micbay/RaceTimerAndController/Images/Adafruit_Bargraph-24_Winner_Lane1_600x125.png

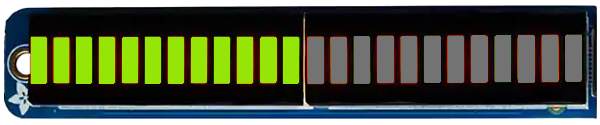
Images/Adafruit_Bargraph-24_Winner_Lane1_600x125.png
