micbay/RaceTimerAndController/Images/ArduinoNanopPinOut_RealHardware.png

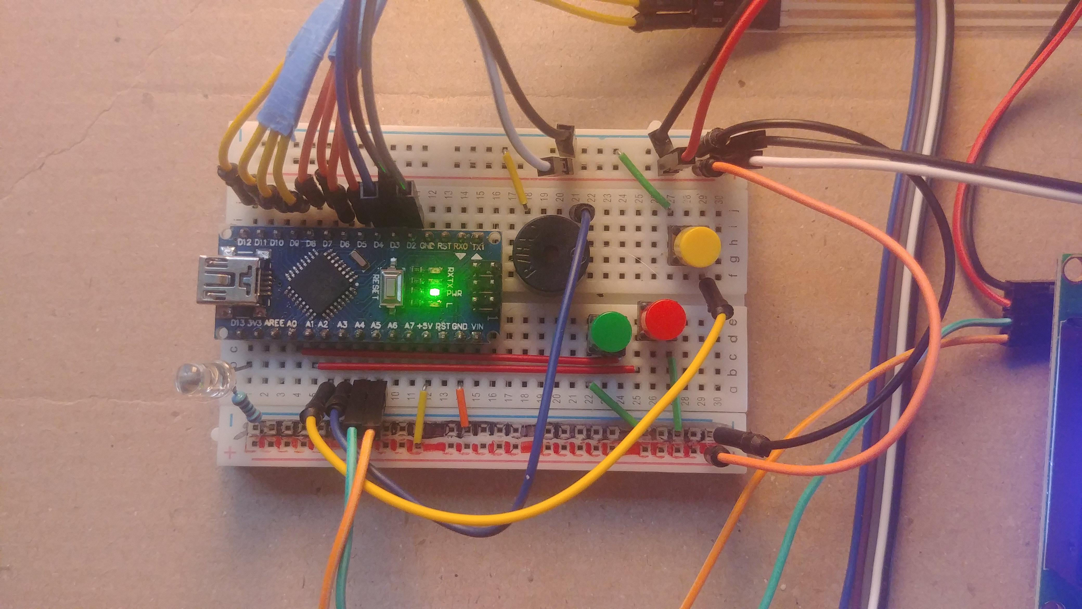
Images/ArduinoNanopPinOut_RealHardware.png
