micbay/RaceTimerAndController/Images/ChangeSettingsWithAudio.png

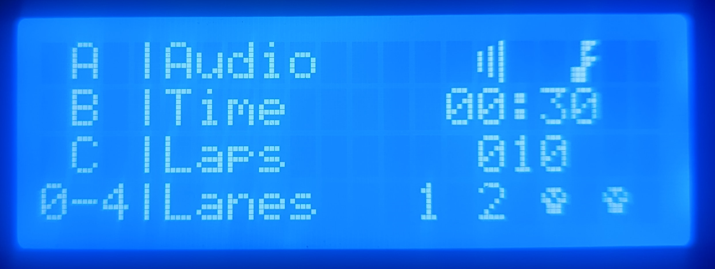
Images/ChangeSettingsWithAudio.png
