micbay/RaceTimerAndController/Images/Displays_DemoStartup.png

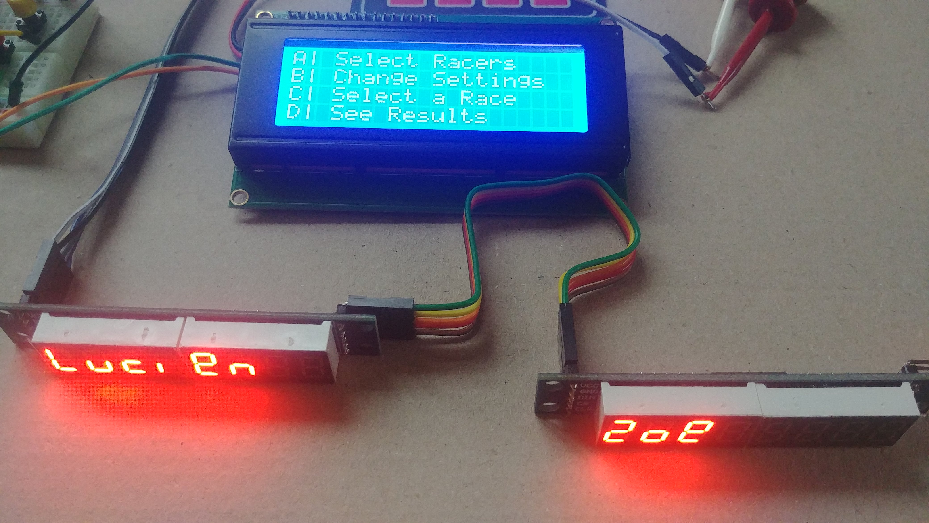
Images/Displays_DemoStartup.png
