micbay/RaceTimerAndController/Images/Hall-Effect-Sensor-Module-KY-003.png

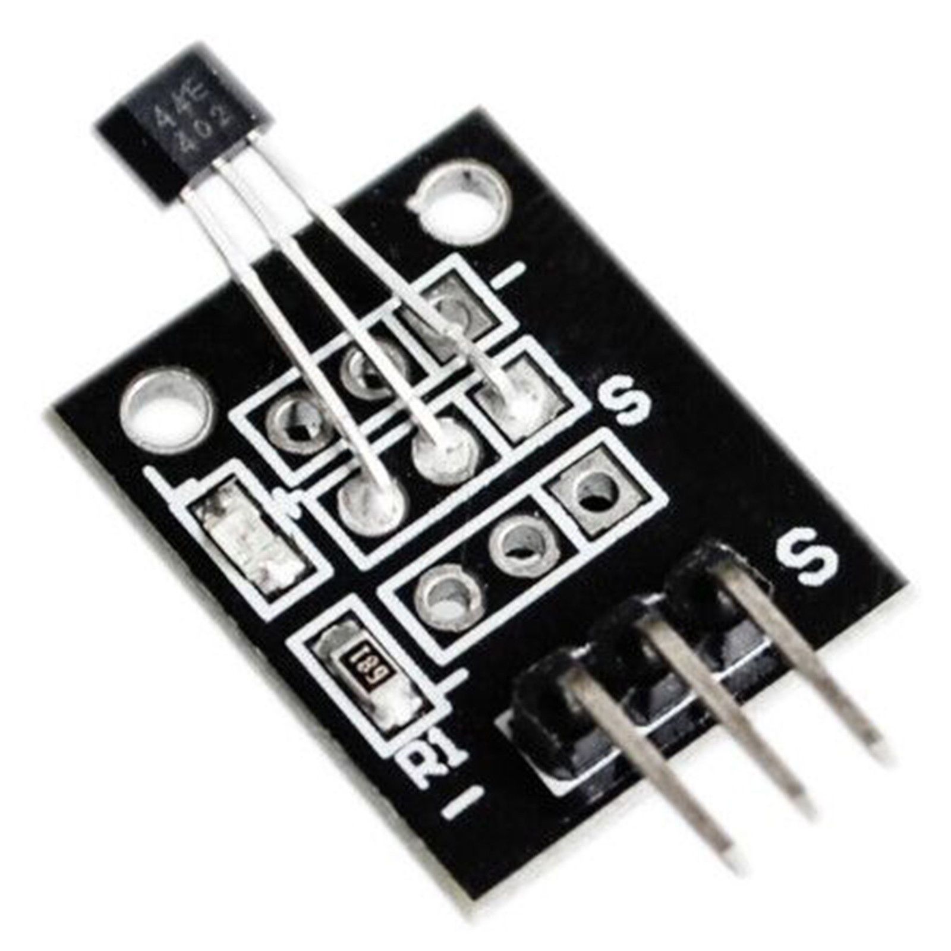
Images/Hall-Effect-Sensor-Module-KY-003.png
