micbay/RaceTimerAndController/Images/LED_PauseScreens.png

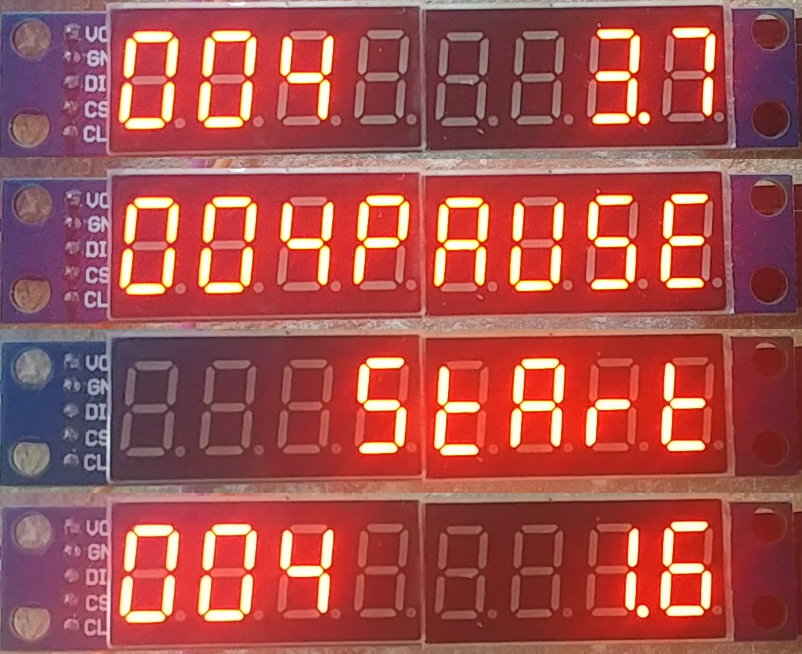
Images/LED_PauseScreens.png
