micbay/RaceTimerAndController/Images/MainMenu.png

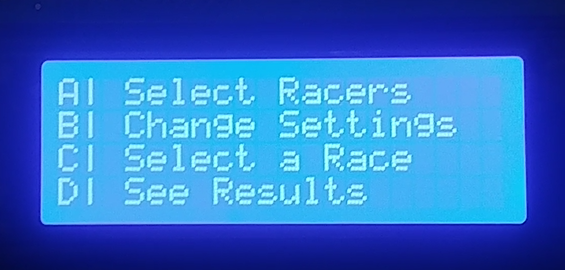
Images/MainMenu.png
