micbay/RaceTimerAndController/Images/Paperclip_Switch_withCar_Strip.png

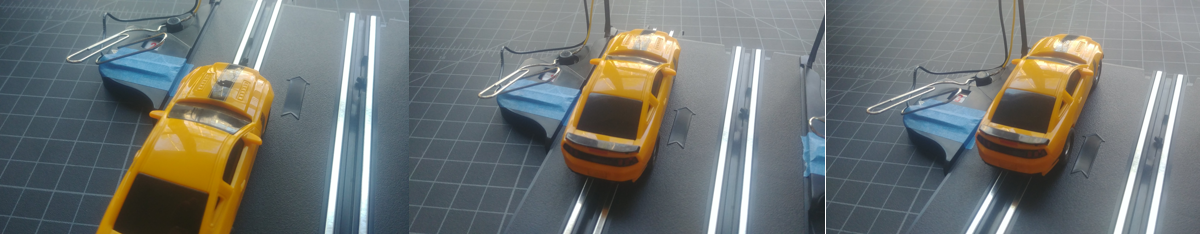
Images/Paperclip_Switch_withCar_Strip.png
