micbay/RaceTimerAndController/Images/pcswitch_withcar1.jpg

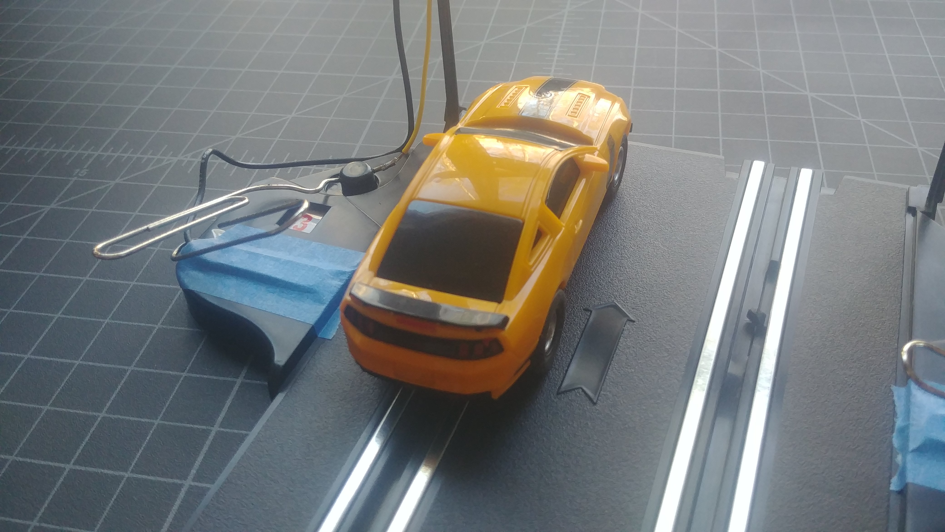
Images/pcswitch_withcar1.jpg
