micbay/RaceTimerAndController/Images/Racer_Display_ssxx.png

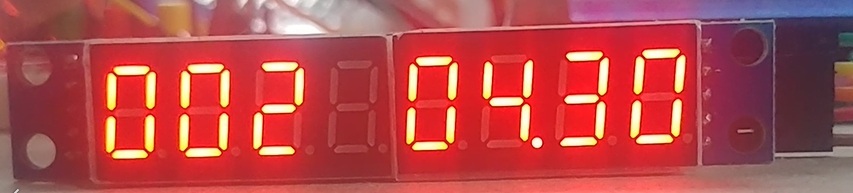
Images/Racer_Display_ssxx.png
