micbay/RaceTimerAndController/Images/Racer_Display_ssxxx.png

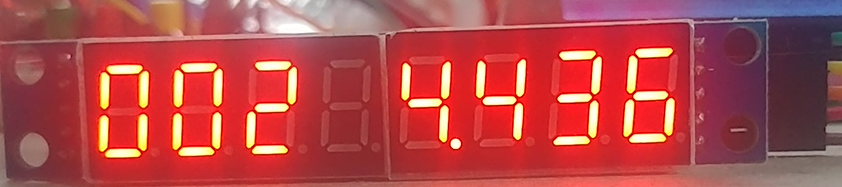
Images/Racer_Display_ssxxx.png
