micbay/RaceTimerAndController/Images/ScreenShots/StartRace_Menu.png

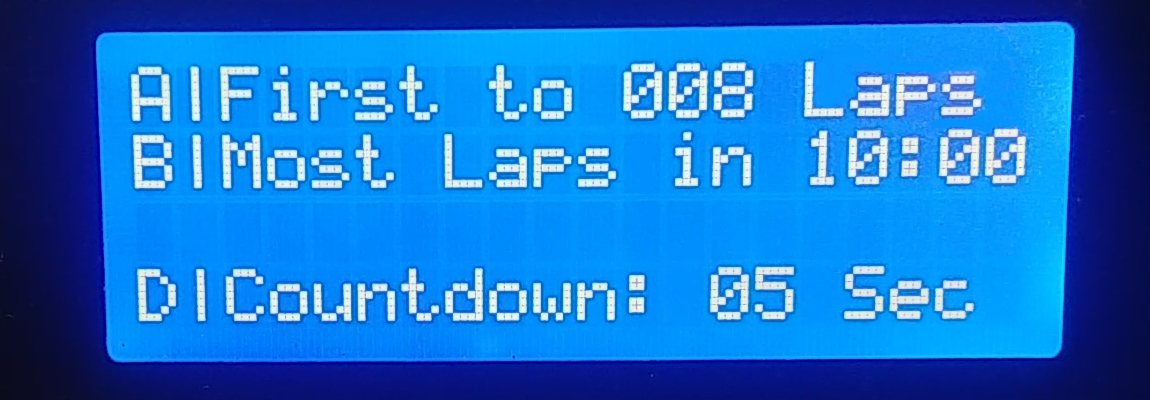
Images/ScreenShots/StartRace_Menu.png
