micbay/RaceTimerAndController/Images/10uF_CapSoldered.png

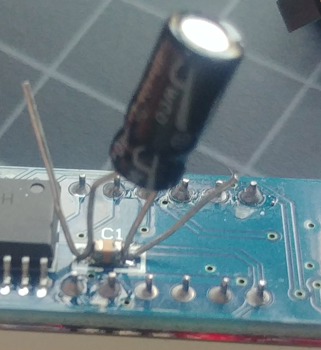
Images/10uF_CapSoldered.png
