micbay/RaceTimerAndController/Images/GroundLoopEx_Bad_Wiring.png

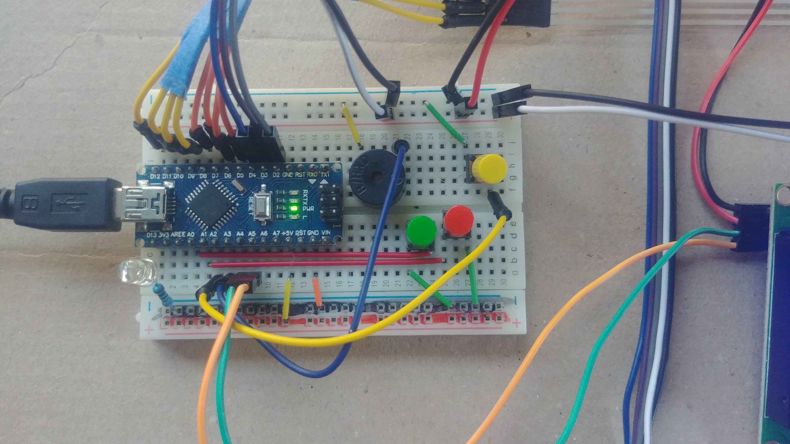
Images/GroundLoopEx_Bad_Wiring.png
