micbay/RaceTimerAndController/Images/WiringDiagram1600x800.png

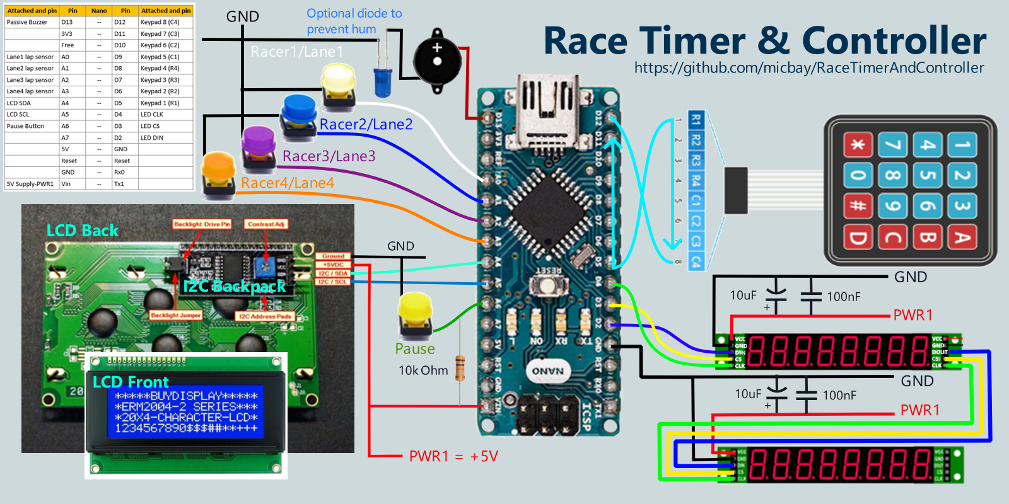
Images/WiringDiagram1600x800.png
