micbay/RaceTimerAndController/Images/ScreenShots/Racer1Results_ScrolledDown_Menu.png

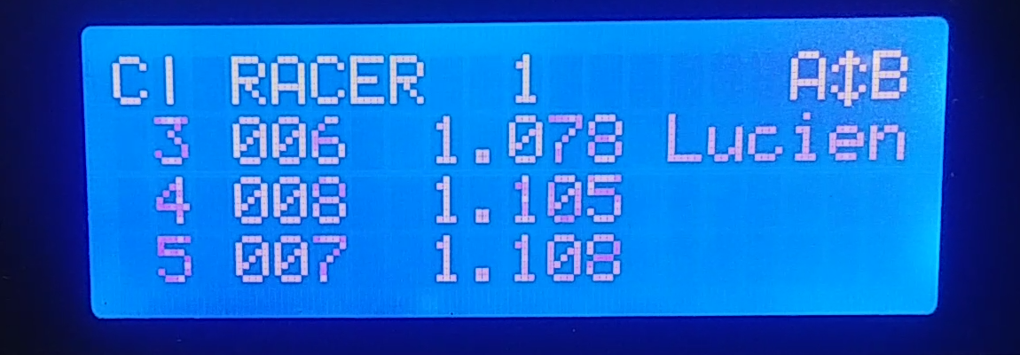
Images/ScreenShots/Racer1Results_ScrolledDown_Menu.png
