micbay/RaceTimerAndController/(threads)

Thread 1 (2023-01-02):

Wrong racer name in live race results view

zhvial, 2023-01-02:
Even through  you change racer name in menu - live race display shows racer names 1 and 2 from Racers[] array. 7 segment display shows correct names, end results are also corrrect, but live race display and "finish" display is not correct. Also winning melody is playing for first or second racer from array, whatever racer you have selected  before from menu.

Here is the video where I'm showing the bug
[https://youtu.be/86N7HagvqQE](https://www.youtube.com/watch?v=86N7HagvqQE)

zhvial, 2023-01-03:
I've found how to solve the problem.
I do not know how to make pull request so posting here:

line 2085:
startPlayRtttlPGM(buzzPin1, victorySong[laneRacer[i]]);

line 2113
startPlayRtttlPGM(buzzPin1, victorySong[laneRacer[leaderBoard[0][1]]]);

line 1453

PrintText(Racers[laneRacer[leaderBoard[k-1][1]]], lcdDisp, 11, 6, false, k);

line 1458

PrintText(Racers[laneRacer[overallFastestRacer]], lcdDisp, 19, 6, false, 3);

micbay, 2023-01-05:
I have added the above changes and the current master branch should now contain the fix. Thanks for finding it and posting it.

Closed 2023-01-05.

Thread 2 (2023-01-02):

Pin definition does not change pin assignation to racing lines.

zhvial, 2023-01-02:
In the code there is pin definition. It is confusing, because if you change the order of lines (lets say you wand A3 for lane1) it doesnt affect the program.

const byte lane1Pin = PIN_A0;
const byte lane2Pin = PIN_A1;
const byte lane3Pin = PIN_A2;
const byte lane4Pin = PIN_A3;

All the "magic" is done in ISR routine where bits are checked.

// Lane 1 positive trigger PINC = 0xXXXXXXX0
  // Lane 1 is on pin A0 which uses the 1st bit of the register; idx 0, of PINC Byte
  // Lane 2 positive trigger PINC = 0xXXXXXX0X
  // Lane 2 is on pin A1 which uses the 2nd bit of the register; idx 1, of PINC Byte
  // Lane 3 positive trigger PINC = 0xXXXXX0XX
  // Lane 3 is on pin A2 which uses the 3rd bit of the register; idx 2, of PINC Byte
  // Lane 4 positive trigger PINC = 0xXXXX0XXX
  // Lane 4 is on pin A3 which uses the 4th bit of the register; idx 3, of PINC Byte

I think that at least comment should be added that pins are not interchangeable

micbay, 2023-01-05:
Yeah, this was originally the plan to make it settable, but wound up using a bit shifting approach to maximize the speed through the ISR() and that broke being able to use the lane#Pin variables for the interrupts which had the side effect of locking in the interrupt byte index value to the lane#.

I've refactored it now so that there is a lanes[][] array that sets the pin and interrupt byte pair for each lane #. So now if you want to wire the pins to different lanes you can do that by just changing the row its associated pin-byte pair is in. The row of lanes[] is equal to the lane. Row zero is reserved, row 1 is lane 1, etc.

The new lanes[] variable is described in code starting around line #52

I added an example commented in the new code at line 80, showing how one might now set pin A3 to be used by lane 1,

Let me know if this didn't cover the functionality you were looking for above.

Thread 7 (2023-01-02):

Count down timer

zhvial, 2023-01-02:
After less than minute is left on count down race timer, minute chars are not deleted and 01: minute is shown.
Video link below:
https://youtu.be/AJK_NrQgwsg

micbay, 2023-01-05:
This problem was due to some errors in the PrintClock() function and PrintSpanOfChars() functions related to calculating the print width.
As the total space needed to print the current time was reduced by a clock countdown from needing minutes to just needing seconds, the part of the clock no longer used was not being cleared.
I have updated the PrintClock() to properly calculate actual clock space used and thus, also the space that needs to be cleared when no longer used.
At the same time I changed the PrintSpanOfChars() to use 'int' variables instead of 'byte' variables so that negative positions can be considered. I don't think that was part of the problem here, but was done because negative position is a possibility.
Should be fixed now in the current master.

Closed 2023-01-05.

Thread 12 (2023-03-10):

Loop in race laptimer and name

sommo, 2023-03-10:
Hi @micbay, I get it working (the startlightI2C) version.
But when choosing racer the display name is incomplete:
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
Also the chained one

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

Once the race is started, it seems getting in loop:
https://user-images.githubusercontent.com/22022996/224379609-51754355-ae42-4162-b391-85388f1c4b57.MOV

I didn't soldered any capacitor behind the two chained display, and didn't connect the Adafruit ledbar (didn't arrive yet).
Any ideas?
Thank you

sommo, 2023-03-10:
for the loop while racing, seems about the pause button, i checked again the connection (it has already the 10k resistor but i grounded better) and now it's ok, while racing no more pause/restart.
Remains the wired about display name, because on count down, all the 8digit turn on (3..2..1..) all of them, so it seems about name and pause/restart string.

I also get an "issue" the one who wins get the losing song (no idea why) and the loser one get the victory song.

micbay, 2023-03-10:
Regarding the 'Z' not showing up on LED.
You need to update the character array used by the library `LedControl.h`. The native library doesn't include every writable character so I edited it. It may not be clear from the readme, but the table shown there is a version I customized and then copied into my version of the library `LedControl`.

To get some extra letters copy the customized table from the readme (shown below) into the `LedConrol.h` file of your downloaded `LedControl` library, which, by default on windows, is found in folder:
`C:\Users\username\Documents\Arduino\libraries\LedControl\src`.

Open `LedControl.h` and swap the variable `const static byte charTable [ ]` with the one below.
```
const static byte charTable [] PROGMEM  = {
  //00  0         1         2          3        4         5         6         7
    B01111110,B00110000,B01101101,B01111001,B00110011,B01011011,B01011111,B01110000,
  //08  8         9         0         b          c        d         E         F
    B01111111,B01111011,B01110111,B00011111,B00001101,B00111101,B01001111,B01000111,
    B00000000,B00000000,B00000000,B00000000,B00000000,B00000000,B00000000,B00000000,
    B00000000,B00000000,B00000000,B00000000,B00000000,B00000000,B00000000,B00000000,
  //32                                                                        '
    B00000000,B00000000,B00000000,B00000000,B00000000,B00000000,B00000000,B00000010,
    B00000000,B00000000,B00000000,B00000000,B10000000,B00000001,B10000000,B00000000,
  //48  0         1         2          3        4         5         6         7
    B01111110,B00110000,B01101101,B01111001,B00110011,B01011011,B01011111,B01110000,
  //56  8         9
    B01111111,B01111011,B00000000,B00000000,B00000000,B00000000,B00000000,B00000000,
  //64            A         B         C       D->d        E         F         G
    B00000000,B01110111,B01111111,B01001110,B00111101,B01001111,B01000111,B01011110,
  //72  H         I         J         K         L         M         N         O
    B00110111,B00000110,B01111100,B00000000,B00001110,B00000000,B00010101,B01111110,
  //80  P       Q->q      R->r        S       T->t        U         V         W
    B01100111,B01110011,B00000101,B01011011,B00001111,B00111110,B00000000,B00000000,
  //88  X         Y         Z         K                                       _
    B00000000,B00111011,B01101101,B00000000,B00000000,B00000000,B00000000,B00001000,
  //96          a->A        b         c         d         e       f->F        g
    B00000000,B01110111,B00011111,B00001101,B00111101,B01101111,B01000111,B01111011,
  //104 h         i       j->J        k         l         m         n         o
    B00010111,B00000100,B00111100,B00000000,B00000110,B00000000,B00010101,B00011101,
  //112 p         q         r       s->S        t         u         v        w
    B01100111,B01110011,B00000101,B01011011,B00001111,B00011100,B00000000,B00000000,
  //120 x         y       z->Z
    B00000000,B00111011,B01101101,B00000000,B00000000,B00000000,B00000000,B00000000
};
```

micbay, 2023-03-10:
I don't fully understand what you are describing about the Pause, however, there is a bug I fixed while editing to add a Drag racing option related to the Pause button that is likely the issue.

Try going to line 1332, I believe, inside of the `ToggleRacePause()` function and swapping:
the old bad line,
```  int logMillis = millis();```
with the new bug fix line:
```unsigned long logMillis = millis();```

The integer variable type is not big enough to hold the running ms time and so it overruns and eventually the debounce time is not being honored. So, you are probably getting multiple triggers on a single press because the contact bounce is not being properly filtered.

sommo, 2023-03-10:
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

didin't saw it, sorry, i corrected it, and now all letters appears, except the K, but i will change the name without K, don't know why because it's seem mapped with your custom charTable

micbay, 2023-03-10:
'K's are not possible because it looks like an 'H'. The letters in the table are above the binary value that represents them, not below.

sommo, 2023-03-10:
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

i also modified this and the pause is correct, anyway as before (was a problem about right grounding the button).

sommo, 2023-03-10:
maybe i get what going wrong about victory song vs losersong.
Who wins and get second is right reported in the display, the problem is only about the song.
Racer1 no matter it will get the loser song and Racer2 will get every time the victory song.

sommo, 2023-03-10:
> 'K's are not possible because it looks like an 'H'. The letters in the table are above the binary value that represents them. The letters are code comments, they are not actually part of the table. All of the characters whose value is `B00000000` are blank.

the only way to print K: https://www.adafruit.com/product/1911 but i feel is enough change name :D

micbay, 2023-03-10:
Regarding Victory Song
I think this might be a confusion of intent.
The song is not related to the place, it's related to the racer. Every racer is associated with their own song, so when any given racer finishes, the song associated with that racer plays. So the same song plays for Racer 2 no matter what order they finish.

sommo, 2023-03-10:
i completly misunderstandin the link one-to-one to song and racer.. i was thinking a song fo the winner and a song for the loser one.
thank you again, i will close the issue

sommo, 2023-03-10:
sorry, reopening it for a question, how could i change linking racer1 to songx, racer2 to songy?
could you point me the unique link racer-song?
thank you!

micbay, 2023-03-10:
You can edit song-racer associations by editing the song and/or racer arrays in the local settings file.

If you haven't already done so, create a `localSettings.h` file by copying and renaming the `example.localSettings.h` to `localSettings.h`, then open and edit your `defaultSettings.h` and tell it to include the `localSettings.h` settings, by uncomment the code line 15:
```// #include "localSettings.h"```
so that it looks like
```#include "localSettings.h"```

Then to adjust racer-song associations, go to the very bottom of the new `localSettings.h` file. uncomment , `RACERS_SONGS_LIST`, and move/edit the songs you want for a given racer, into the same index as the associated `RACER_NAMES_LIST`. Also, of course, the racer names can be adjusted/edited in the same manner. Make sure the racer and song arrays are always the same length.
Also, **do not** edit the 1st term of the racer name or song arrays as that is reserved for the 'no racer' condition.

If the ability to associate songs with place or to have just a single victory song for the first place finisher is a desired feature, feel free to create a possible feature discussion to document the idea for feedback.
It might be possible at some point to make that an option settable by the `localSettings` file.

sommo, 2023-03-10:
thank you, get it! i will open a new discussion for that

Closed 2023-03-10.

Thread 16 (2023-03-16):

ledbar doesn't turn on

sommo, 2023-03-16:
hi @micbay,
adafruit ledbar arrive today, i've solder it, founded (with an i2c sketch scanner) that it has 0x74 address and test with the example sketch from the library and it works.
So i get back to the main sketch and modified the line 1927 into this to match the right i2c address:

  bar.begin(0x74);

but it doesn't work.
i connected the both (ledbar and LCDdisplay) SDA on A4 pin and both SCL to A5 pin to the arduino nano.
I need to wiring it different?
As always, Thank you!

sommo, 2023-03-16:
i tried again with the i2c scanner sketch, and now reports it has 0x70, changed again the main sketch to 0x70, but nothing, ledbar can't get on... so i'm quite disoriented

micbay, 2023-03-16:
I'm not sure what the range of input voltage is acceptable, maybe the Arduino will regulate the voltage down, but everything in this system are 5V devices. I would stay with a 5V source and make sure that the displays are pulling voltage from the 5V source directly, not through the +5V Arduino pin.
Also, to work through troubleshooting try using the example sketch 'bargraph24' until its working. the default 'bargraph24' sketch example works for me as is using the same wiring and address used for the race controller.

sommo, 2023-03-16:
i have the arduino nano (the not original one), that its working with the 'bargraph24' sketch in a really strange behaviour, if i upload the sketch to it i need to hw reset it about 4 times before getting the ledbar on and reproducing the sketch.
Don't know why, myabe i need to invest money to an arduino nano original.. or revert the sketch to an arduino uno that i own 2 of them

micbay, 2023-03-16:
If the Uno is working, the uno has the same processor as the nano, and should work as a drop in replacement for the nano, with the same race controller code and pinouts.
My nanos are all bootleg cheapo versions and in the past I've had to work out similar odd behavior. Your nano might have a corrupted bootloader or some other issue. You could try reflashing the bootloader or choosing a different compiler, and/or bootloader, from the Arduino IDE, and try different combinations to see if that helps.
You can also use the Uno to reflash the bootloader on the Nano, how to do that is discussed in this article on [Installing an Arduino Bootloader](https://learn.sparkfun.com/tutorials/installing-an-arduino-bootloader/all), and the abbreviated steps are given below.

**To Fix Corrupted Arduino Nano**
Wire as such (uno D10-D13 to Nano ISP header)
Then in Arduino IDE, program the Uno with the example sketch (Arduino ISP)
Then from the 'Tools' menu select 'Burn Bootloader'.
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

sommo, 2023-03-16:
i did it, i flashed the nano with the uno, now i can flash the nano with arduino with the ATmega328P so seems better, in fact i have flashed the main sketch to it but to get the ledbar on i need to hw reset (button on it) only once. better sure cause first were random the number of reset to do.

sommo, 2023-03-16:
after changing the bootloader i notice that while it boots it sound 2 times, before flashing the nano, it sounds only 1 beep while booting.

sommo, 2023-03-16:
anyway now i get this while uploading to the nano
avrdude: stk500_loadaddr(): (a) protocol error, expect=0x14, resp=0x10
avrdude: stk500_loadaddr(): (a) protocol error, expect=0x14, resp=0x10
avrdude: stk500_loadaddr(): (a) protocol error, expect=0x14, resp=0x10
avrdude: stk500_loadaddr(): (a) protocol error, expect=0x14, resp=0x10
avrdude: stk500_loadaddr(): (a) protocol error, expect=0x14, resp=0x10
avrdude: stk500_loadaddr(): (a) protocol error, expect=0x14, resp=0x10
avrdude: stk500_loadaddr(): (a) protocol error, expect=0x14, resp=0x10
and after a few i get it uploaded anyway

micbay, 2023-03-16:
Sounds like maybe there is an options mismatch in the chosen board, programmer, and/or bootloader combination, Did you switch your bootloader option after flashing them to use the current 138P instead of the old one?
My nanos are fairly old, and were reflashed with the older Arduino IDE 1.8, but they work fine with the new IDE 2.0 using the following: select 'Arduino Nano' board type, use the programmer 'AVRISP mkll' and the current 'ATMega138P' bootloader. if I try using 'ATMega138P (old bootloader)', I can replicate a similar error.

micbay, 2023-03-16:
For me, when I upload a sketch I get 3 rapid beeps after it compiles/starts the upload, and 1 beep after it finishes uploading. The Race Controller code also commands a beep on bootup.
Sometimes after an upload I need to power cycle the system, not just push the Arduino reset button, but unplug power to all devices, and plug it back in to get everything reset to an operable condition. Since not all power goes through the Arduino pushing the reset doesn't always reset displays and peripherals that are powered directly and they can end up in an odd state.

sommo, 2023-03-17:
i would try to use the Arduino IDE 1.8 maybe i get the nano working properly but i get this while compiling:

```
/Users/sommo/Downloads/RaceTimerAndController-StartLightI2C 3/RaceTimerAndController/RaceTimerAndController.ino: In function 'void PrintClock(ulong, byte, byte, byte, displays, byte, bool)':
/Users/sommo/Downloads/RaceTimerAndController-StartLightI2C 3/RaceTimerAndController/RaceTimerAndController.ino:1007:22: warning: converting to non-pointer type 'long unsigned int' from NULL [-Wconversion-null]
         decimalSec = NULL;
                      ^~~~
/Users/sommo/Downloads/RaceTimerAndController-StartLightI2C 3/RaceTimerAndController/RaceTimerAndController.ino: In function 'void loop()':
/Users/sommo/Downloads/RaceTimerAndController-StartLightI2C 3/RaceTimerAndController/RaceTimerAndController.ino:1993:35: warning: invalid conversion from 'const char* const*' to 'const char**' [-fpermissive]
             UpdateLCDMenu(MainText);
                                   ^
/Users/sommo/Downloads/RaceTimerAndController-StartLightI2C 3/RaceTimerAndController/RaceTimerAndController.ino:651:6: note:   initializing argument 1 of 'void UpdateLCDMenu(const char**)'
 void UpdateLCDMenu(const char *curMenu[]){
      ^~~~~~~~~~~~~
/Users/sommo/Downloads/RaceTimerAndController-StartLightI2C 3/RaceTimerAndController/RaceTimerAndController.ino:2025:39: warning: invalid conversion from 'const char* const*' to 'const char**' [-fpermissive]
             UpdateLCDMenu(SettingsText);
                                       ^
/Users/sommo/Downloads/RaceTimerAndController-StartLightI2C 3/RaceTimerAndController/RaceTimerAndController.ino:651:6: note:   initializing argument 1 of 'void UpdateLCDMenu(const char**)'
 void UpdateLCDMenu(const char *curMenu[]){
      ^~~~~~~~~~~~~
/Users/sommo/Downloads/RaceTimerAndController-StartLightI2C 3/RaceTimerAndController/RaceTimerAndController.ino:2090:43: warning: invalid conversion from 'const char* const*' to 'const char**' [-fpermissive]
             UpdateLCDMenu(SelectRacersText);
                                           ^
/Users/sommo/Downloads/RaceTimerAndController-StartLightI2C 3/RaceTimerAndController/RaceTimerAndController.ino:651:6: note:   initializing argument 1 of 'void UpdateLCDMenu(const char**)'
 void UpdateLCDMenu(const char *curMenu[]){
      ^~~~~~~~~~~~~
/Users/sommo/Downloads/RaceTimerAndController-StartLightI2C 3/RaceTimerAndController/RaceTimerAndController.ino:2142:40: warning: invalid conversion from 'const char* const*' to 'const char**' [-fpermissive]
             UpdateLCDMenu(StartRaceText);
                                        ^
/Users/sommo/Downloads/RaceTimerAndController-StartLightI2C 3/RaceTimerAndController/RaceTimerAndController.ino:651:6: note:   initializing argument 1 of 'void UpdateLCDMenu(const char**)'
 void UpdateLCDMenu(const char *curMenu[]){
      ^~~~~~~~~~~~~
Lo sketch usa 27730 byte (90%) dello spazio disponibile per i programmi. Il massimo è 30720 byte.
Le variabili globali usano 1609 byte (78%) di memoria dinamica, lasciando altri 439 byte liberi per le variabili locali. Il massimo è 2048 byte.
```

sommo, 2023-03-17:
anyway it compile the sketch, and upload it but still get same issue on ledbar, it doesn't turn on... i will try to move to the arduino uno and let you know.

sommo, 2023-03-17:
For me, when I upload a sketch I get 3 rapid beeps after it compiles/starts the upload, and 1 beep after it finishes uploading. The Race Controller code also commands a beep on bootup.
=> me too but i still have ledbar always off

sommo, 2023-03-17:
you could not believe in this...: i order 2 ledbar adafruit (cause was convenient).
i just completed to soldered the second one, and with that all works like shold do...
i plugged back the first adafruit ledbar and it comes out that it changes address to 0x74, like i have noticed before... seems something wrong on it.. could it be a soldering problem? i don't know if i could try to soldered one of the couple behind A0/A1/A2 to force a fixed i2c address.. never done before

sommo, 2023-03-17:
forced to use 0x74 and seems good also with the first ledbar. i will close the issue, thank you @micbay

micbay, 2023-03-17:
Maybe there is a bad solder joint on the address resistors which is causing it to have an intermittent connection, which in turn is causing the address to change as the bad solder joint comes in and out of connection. Double check the solder joints on the resistors, and possibly the chip too. If you feel confident with a soldering iron you can just go around each solder joint and briefly heat them to rewet the solder. The solder will automatically pull itself around the pin and solder pads, fixing any cracked solder joints that might be there.
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

To get an address of `0x74` suggests the board thinks that jumper pad `A2` is shorted.

For folks coming to this thread later, here is the [Adafruit I2C addressing guidance](https://learn.adafruit.com/adafruit-led-backpack/changing-i2c-address), and the gist is reprinted below.

Possible I2C addresses for Bi-color 24-bargraph: `0x70`, `0x71`, `0x72`, `0x73`, `0x74`, `0x75`, `0x76`, `0x77`
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
Set the address by shorting the pads on the jumper resistors, shown above.
- `A0` sets the lowest bit with a value of 1,
- `A1` sets the middle bit with a value of 2.
- `A2` sets the high bit with a value of 4.
- The final address is `0x70` + `A2` + `A1` + `A0`.
- Example: if `A2` is shorted and `A0` is shorted, the address is `0x70` + 4 + 1 = `0x75`. If only `A1` is shorted, the address is `0x70` + 2 = `0x72`

micbay, 2023-03-17:
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

I'm not sure what this is. I note that it's pointing to your windows `Downloads` folder though which seems odd. You had a weird path on another error you posted in another thread too. You might be somehow, accidentally using files that are in the wrong folder, If you download the code repo and then open it from inside the downloads folder, or are copying files that are not actually unzipped, but appear to be in the file navigator, that might be creating a file reference issue. Accidentally using an unzipped file or opening the `.ino` file from an unexpected directory could be throwing off the Arduino IDEs expected file paths used when it compiles  the `#include` files and libraries. Same thing goes if you downloaded libraries manually, instead of through the Adruino Library manager interface. If you see an error referencing a file path including the names of one of them.

Double check that you are always working from the `.ino` file in this directory:
`C:\Users\winusername\Documents\Arduino\RaceTimerAndController`

and, double check that your Arduino IDE's path settings makes sense:
For Arduino IDE 2.0 go to `File->Preferences->Settings` and make sure your 'Sketchbook location:' is still where you want it. By default it should be pointing to `c:\Users\winusername\Documents\Arduino`

Closed 2023-03-17.
