micbay/RaceTimerAndController/defaultSettings.h

  #define LANE_COUNT 2
  #define DEFAULT_MAX_STORED_LAPS 20
  #define SINGLE_DRAG_TRIGGER false
  #define CTDWN_ON_RESTART false
  #define DEBOUNCE 500
  #define DRAG_HEAT_TIMEOUT 10
  #define DEFAULT_LAPS 10
  #define DEFAULT_SET_MIN 0
  #define DEFAULT_SET_SEC 30
  #define DEFAULT_COUNTDOWN 5
  #define DEFAULT_REFRESH_TICKS 100
  #define DEFAULT_FLASH_PERIOD_LENGTH 1500
  #define START_LIGHT_OFF_DELAY 2000
  #define DRAG_PRESTART_CNTDWN_BASE 4
  #define DRAG_PRESTART_RNDM 3
  #define LANE1 {PIN_A0, 0b00000001}
  #define LANE2 {PIN_A1, 0b00000010}
  #define LANE3 {PIN_A2, 0b00000100}
  #define LANE4 {PIN_A3, 0b00001000}
  #define PCINT_VECT PCINT1_vect
  #define INTERRUPT_PORT PINC
  #define BARGRAPH_I2C_ADDRESS 0x70
  #define PAUSEPIN PIN_A6
  #define STARTPIN PIN_A7
  #define BUZZPIN 13
  #define BEEP_FREQ 4000  // freq in Hz
  #define BEEP_DUR 200    // duration in ms
  #define BOOP_FREQ 1000  // freq in Hz
  #define BOOP_DUR 200    // duration in ms
  #define BLEEP_FREQ 2000  // freq in Hz
  #define BLEEP_DUR 600    // duration in ms
  #define DEFAULT_AUDIO_MODE AllOn
  #define LCD_COLS 20
  #define LCD_ROWS 4
  #define RACE_CLK_POS 8
  #define PRESTART_CLK_POS 11
  #define PIN_TO_LED_DIN 2
  #define PIN_TO_LED_CS 3
  #define PIN_TO_LED_CLK 4
  #define A_SELECT_RACER "A| Select Racers"
  #define B_CHANGE_SETTINGS "B| Change Settings"
  #define C_START_RACE "C| Start a Race"
  #define D_SEE_RESULTS "D| See Results"
  #define A_RACER1 "A|Racer1"
  #define B_RACER2 "B|Racer2"
  #define C_RACER3 "C|Racer3"
  #define D_RACER4 "D|Racer4"
  #define A_SETTING_AUDIO " A |Audio"
  #define TIME_SETTING_POS 14
  #define B_SETTING_TIME " B |Time       :"
  #define C_SETTING_LAPS " C |Laps"
  #define D_SETTING_LANES "0-4|Lanes"
  #define START_RACE_LAPS_ENDPOS_IDX 19
  #define A_START_RACE_STANDARD "A|Laps Race to:"
  #define START_RACE_TIME_ENDPOS_IDX 19
  #define B_START_RACE_IMED "B|Timed Race:"
  #define START_RACE_3RD_ROW "C|Drag Race"
  #define START_RACE_CNTDWN_ENDPOS_IDX 19
  #define D_START_RACE_COUNTDOWN "D|PreStart (Sec):"
  #define TEXT_PRESTART "Your Race Starts in:"
  #define TEXT_PRESTART_STRPOS 0
  #define FINISH_DNF "DNF"
  #define FINISH_1ST "1st"
  #define FINISH_2ND "2nd"
  #define FINISH_3RD "3rd"
  #define FINISH_4TH "4th"
  #define NO_RACE_DATA "-NO RACE DATA-"
  #define COMPILING "-Compiling-"
  #define RESULTS_TOP_LBL "C| TOP RESULTS"
  #define RESULTS_TOP_TEXT_BEST "Best"
  #define RESULTS_TOP_TEXT_LAP "Lap"
  #define RESULTS_RACER_BLINK 2000
  #define RESULTS_RACER_LBL "C| RACER "
  #define RESULTS_RACER_NUM_POS 10
  #define RESULTS_FINISH_LBL "C| FINISH"
  #define RESULTS_TOTAL_LBL "Total"
  #define RESULTS_TOTAL_LBLA "Time"
  #define RESULTS_TOTAL_LBLB "Laps"
  #define TEXT_START "Start"
  #define TEXT_PAUSE "PAUSE"
  #define TEXT_OFF "-Off-"
  #define RACER_NAMES_LIST {TEXT_OFF, "Lucien", "Zoe", "Elise", "John", "Angie", "Uncle 1", "Rat2020_longer", "The OG", "5318008"}
  #define RACER_SONGS_LIST {disabledTone, starWarsImperialMarch, takeOnMeMB, airWolfTheme, tmnt1, gameOfThrones, galaga, outrun, starWarsEnd, spyHunter}
  #define SONGS_BY_PLACE false
