micbay/RaceTimerAndController/(commit log)

2021-12-14 Discovered error in 'enterNumer' function, was using pow() with int which was dropping value by 1 due to rounding error. Replaced with custom integer power function.
2021-12-16 Buttons that trigger a registry interrupt has been implemented and working.
2021-12-16 Pre-race countdown working with LED bars when under 10sec and properly tranistioning to race start.
2021-12-16 Updated lcdPrintClock function to take in a digit width variable to say if it leads with H, M, or S. Corrected pre-start LED count to turn on start of digit.
2021-12-16 added build directory and thus first appearance of .gitignore file to ignore it. Changed Racers[] from an array of strings to an array of charactera arrays. started ledWriteName().
2021-12-18 added basic tone variables and implemented beep with menu button press (except number entry). removing .vscode folder from tracking.
2021-12-19 updated WriteName to be for both displays and to have more control over printing position and justification.
2021-12-20 Taking snapshot before changing PrintClock. working on replacing leading zeros function with a more efficient and general print number function.
2021-12-20 PrintWithLeadingZeros completely replaced by PrintNumbers. Printing running time to LED now working with new function.
2021-12-22 Added standard race finish. 1st and 2nd place written to appropriate LED display. Lap tracking arrays updated to be a fastest array and lastX array for each racer.
2021-12-24 Cleaned up code with better comments, fixed some minor bugs due to typos, add wiring diagram png to repo.
2021-12-25 Race results list fully implemented. Standard race fully implemented. Timed race not yet addressed. Leading zero options added to timers and digit adjustment for over 60sec has been added.
2021-12-27 Something is odd with the PCI interrupt enabling and disabling. This snapshot to allow going back to check earlier code.
2021-12-28 Finished implementing LED and lcd updating to changes in racers being enabled or disabled. Other than adding music and error checking and corner case testing, the program is now complete.
2021-12-29 Initial commit with new branch for adding full melodies to program. Available RAM is getting short, longer songs (70+) notes cause errors currently.
2021-12-29 Tune playing function complete and working. Memory seems ok at around 75%, but seem to be getting some issues with 2nd LED if playing while starting race. Could be wiring or power related.
    [melodies_prog.h]
2021-12-29 Snapshot after implmenting PlayRTTTL library successfully to play songs. Noticing issues with 2nd LED display. Looks like memory issues, but could be signal noise/power related. RAM is at a min of 75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
    [RTTTL_songs.h, melodies_prog.h]
2021-12-30 Finished adding aduio toons and personal victory songs. Fixed lcd clearing on Pause restart, now maintains existing lap and best. Other than cleanup this version is complete of major functions and ha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
    [RTTTL_songs.h, melodies_prog.h]
2022-01-20 Updates to buzzer melody play function for array method. Racer victory song now plays when racers is selected in selection menu. Corrected buzzer hardware to 'Passive' buzzer. Active buzzer works in 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
    [melodies_prog.h]
2022-01-21 First commit after changing repo name from SlotCarRaceController to RaceTimerAndController, also trying to remove legacy .vscode folder and files that are supposed to be ignored.
2022-01-21 Fixed position of lap time in results table. Made some minor typo and format edits. This is a snapshot before changing approach with 'PrintClock()' to be independant of knowing the time.
    [RaceTimerAndController.ino, melodies_prog.h]
2022-01-23 Major update - Revamped PrintClock() so that given a width and time it auto adjusts precision (decimal places). Updated the lcdClearLine() to be generic writeCharacterSpan() that prints any given cha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
2022-01-23 corrected bitwise & operators that were being used improperly as boolean and '&&'. Minor comment changes. This is a snapshot before making major changes to the ISR.
    [RaceTimerAndController.ino]
2022-01-23 updated the audio array playing function to shorten played note keeping tempo of song as set. Also updated all variables whose label references 'count' to be called 'size' when recording note array l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
    [RaceTimerAndController.ino, melodies_prog.h]
2022-01-23 Added a micro() timer to the ISR function. This is very finicky with the available memory, but helps to see how long it's taking to execute the lap detection, which is about 175micro-sec, a little le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
2022-01-24 Updated Settings menu with new 4 racer setup. LED name writting and initialization is working.
2022-01-25 Major updates to Settings Menu interface to accomodate 4 lanes. Same with Racer name select screen. Racer selection and lane enabe/disable, along with LED updaes, accordingly, is complete. Still to c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
2022-01-25 Major Update - all variables converted to a 1-4 racer format no longer are any lane specific single variables being used. Still need to update race functions to all accomodate 4 racers. Some old 2 ra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
    [RaceTimerAndController.ino]
2022-01-25 Taking a snapshot before re-arranging ISR comparisons. Moving the debounce outside of lanestatus. it doesn't change function but looking to minimiz the most common order.
    [RaceTimerAndController.ino]
2022-01-26 Snapshot after changing lapflash to for loop. Acting odd, but hard to tell if it is a noise issue.
    [RaceTimerAndController.ino]
2022-01-26 Major Status Snapshot - 4 racers working for race triggers, LED display updates, and results collection. Lat part to update is the race finish and LCD display content for live race. All else is worki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
2022-01-27 Major Bug fixes - fixed errors in ISR, reset race variables, and other array call errors that caused problems with debouncing. Lane status was not being reset to StandBy and array indexing was mixed 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
    [RaceTimerAndController.ino]
2022-01-27 Major Update - Finished first working iteration of running Leader Board. Still several bugs and to tie it into race completion for each racer and over all.
    [RaceTimerAndController.ino]
2022-01-27 Found why LEDs have been flashing because they are getting cleared each tick instead of only when switching flash states. This is a snapshot before changing the finish approach which probably involve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
2022-01-28 Major Update - Completed updated finish for all racers. Added finish menu to the indexable results pages, added best lap time to the leader board. Fixed bugs with writing to displays not getting clea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
    [RaceTimerAndController.ino]
2022-01-28 Fixed LCD time dropping zeros on decimal places. It was erroneously turning .050 into 50ms which was getting printed as .50 which was wrong. Added custom characters for arrows and some icons on LCD. 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
    [RaceTimerAndController.ino]
2022-01-30 FULLY COMPLETE - Timed racing finsish has been fully implemented. Updated way of handling racer name display on LEDs. All known bugs and desired cosmetic tweaks have been completed.
    [RaceTimerAndController.ino]
2022-01-31 Updated readme with first draft of lap sensor section, added a video to try if local links work on GitHub.
2022-02-01 Complete a full draft of the readme, adding sections for the lap sensors/port interrupts and the pause button.
2022-02-01 INITIAL PUBLISHABLE STATE - Fixed error in paused race time where it was still elapsing time while paused. Created video demo, uploaded to youtube, and added link in readme. Other than missed bugs or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
    [RaceTimerAndController.ino]
2022-02-02 Some fixes to readme, addition of a header for the charTable so it can get a link for reference by Arduino Project Portal entry.
    [RaceTimerAndController.ino]
2022-02-02 Some readme edits and fixed typos found while adapting for Arduino project hub.
2022-02-03 Commenting Update - just some typo corrections and editorail changes to readme and code commenting.
    [RaceTimerAndController.ino]
2022-02-03 Some more typo fixes and comment/readme refinements.
    [RaceTimerAndController.ino]
2022-05-14 Added alternate code for using Arduino Mega2560 and updated readme, correcting typos and adding clarifications.
    [RaceTimerAndController.ino]
2022-05-16 Fixed hyperlinks for lap sensor examples and references in the readme.
2023-01-05 Fixes for Issues #1 & #7. Corrects reference to racer index to fix wrong racer names displayed on results and live view. Also fixes LCD live race time that was not clearing unused digits when in coun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
    [RaceTimerAndController.ino]
2023-01-05 Fix for Issue #2, added new 'lanes[]' array to define the hardware pin and associated interrupt byte so that builders can adjust which physical pins are wired to which lane in software.
    [RaceTimerAndController.ino]
2023-01-06 Updated readme.md with addition of new lanes[] for associating physical pins and racer/lane#, as well as associated changes to the ISR() and check of pin against the interrupt vector byte. Also inclu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
2023-01-06 Edits to comments in code, update to readme to add notes on suppressing EMI to prevent unwanted change interrupt triggers.
    [RaceTimerAndController.ino]
2023-01-07 Adding note to reference completion of Issue #8, add local customization file.
    [defaultSettings.h, example.localSettings.h]
2023-01-08 Updates to readme and code comments to fix typos, make clarificatoin edits, and sync with latest functionality.
    [RaceTimerAndController.ino]
2023-01-10 Major update to Initial release version 1.0.0; details of commit can be found in new Change_Log.md file. This commit fixes repo issue #9 among other fixes.
    [RaceTimerAndController.ino, defaultSettings.h, example.localSettings.h]
2023-03-06 Initial commit for I2C start light code base.
2023-03-12 Snapshot after significant code edits. Restructure of several functions into states and drag racing features is completed. Just usage tweaks and code cleanup left. Moved enums to a seperate .h file t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
    [RaceTimerAndController.ino, enum_lists.h]
2023-03-15 Drag Race race option is fully functional and all known bugs have been addressed. Code cleanup, commenting, and documentation related to these chanes are still TODO items.
    [RaceTimerAndController.ino, defaultSettings.h]
2023-03-16 Option to have a countdown on a restart from a pause. All V2.0 features have been completed and clear of any known bugs. Updates to documentaion still pending.
    [RTTTL_songs.h, RaceTimerAndController.ino, defaultSettings.h, example.localSettings.h]
2023-03-19 Clean up commit to address some readme formatting issues.
    [defaultSettings.h, example.localSettings.h]
2023-03-21 README updates: added new sensor images and some clarification edits to the text.
2023-03-21 README updates: Added instruction on changing Adafruit Bargraph I2C address.
2023-07-19 ReadMe update - Added code guidance to startlight sections, updated racer LED code guidance.
